automatous-io/t1n-smart-module/cad/T1NCabinEnclosure.step

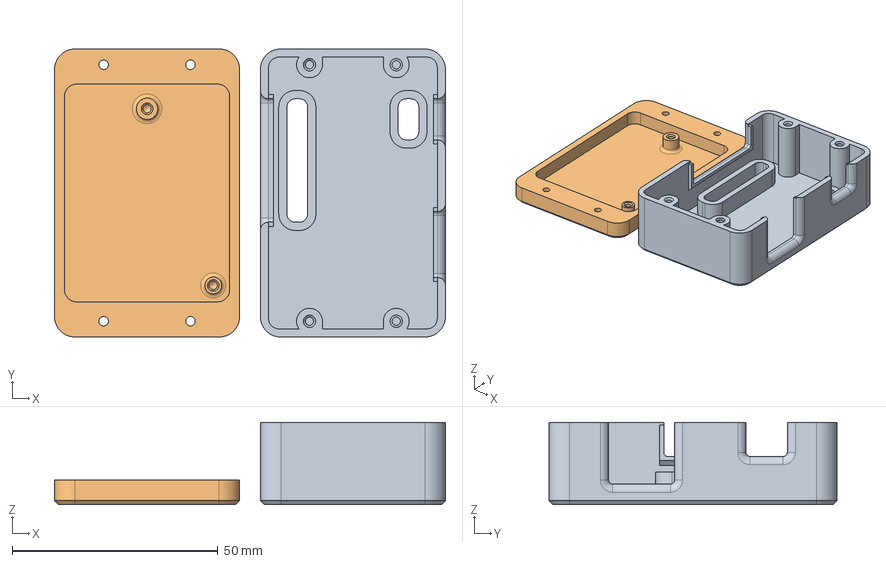
[picture p24: CAD file, 2026-02-17]
cad/T1NCabinEnclosure.step
95.0 x 70.0 x 20.0 mm
