automatous-io/t1n-smart-module/cad/T1NDoorModuleNFCVertical.step

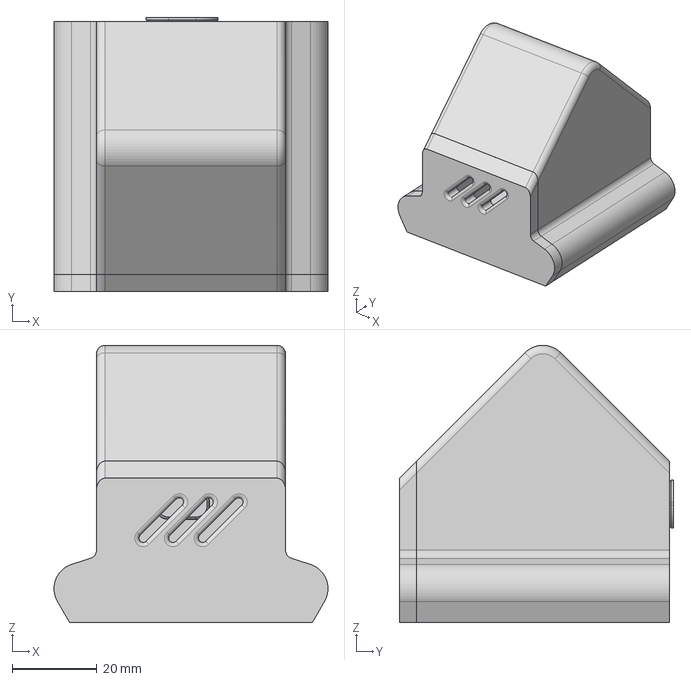
[picture p25: CAD file, 2026-02-17]
cad/T1NDoorModuleNFCVertical.step
64.5 x 64.5 x 65.3 mm
