automatous-io/t1n-smart-module/(list of files, cad)

Other CAD files:
cad/T1NCabinEnclosure.stl
cad/T1NDoorModuleNFCVertical.stl
