automatous-io/t1n-smart-module/(commit log)

2026-02-17 Update README.md
    * updated dependency list
    * updated flash instructions
    * updated board heading to modular perfboard
2026-02-17 Update README.md
    * Added YT demo video of early prototype NFC locking doors to Readme under Prototype heading.
2026-02-17 Add CAD files and images
    [T1NCabinEnclosure.step, T1NCabinEnclosure.stl, T1NDoorModuleNFCVertical.step, T1NDoorModuleNFCVertical.stl]
